Unified-Daughterboard/UDB-S/README.md

# Unified Daughterboard S Series

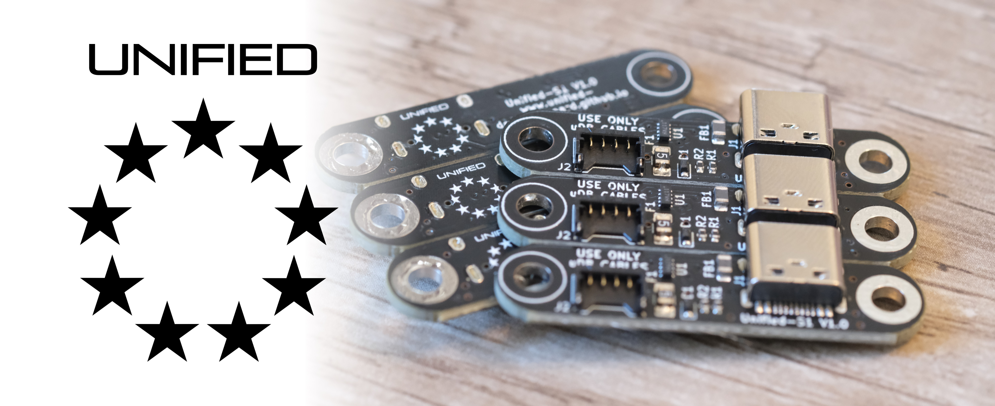
[picture p1: assets/S1-Banner-Img.jpg]
banner


## Introduction
The Unified Daughterboard Project is an open standard to unify the USB daughterboards used in custom mechanical keyboard projects.  
The Unified Daughterboard allows designers to easily implementing electrical protection via a tested proven PCB, and allows users to maintain and repair their keyboards in the future.  
  
For more details on the Unified Daughterboard project, see the [main website](https://unified-daughterboard.github.io/).

## S Series

The S1 variant was developed as an entirely new form factor from the older C3 version based on real-world production usage and designer input.

- "Wide and narrow" 40mm wide x 9mm deep x 1.6mm thick form factor
    - Avoids obstacles such as weights commonly found in custom keyboards
    - Mountable both right-side-up and upside-down
- 2 x M3 mounting points 
    - Fewer large screw taps reduce thread defect issues and assembly effort
- Easy and inexpensive to source via JLCPCB or similar
- Large DB corner radii which allow keyboard cases to be milled at a large inner radius
- ESD protection, overcurrent protection, overvoltage protection, shielding noise decoupling, and single-path grounding to chassis functionality
- New Molex Pico-EZmate Connector, replacing the JST-SH on previous versions
- 1:1 connector pinout to retain compatibility with existing PCBs

## Using the S series uDB in your design
Please [visit the docs](https://unified-daughterboard.github.io/) for detailed implementation references and notices.  

## Previews
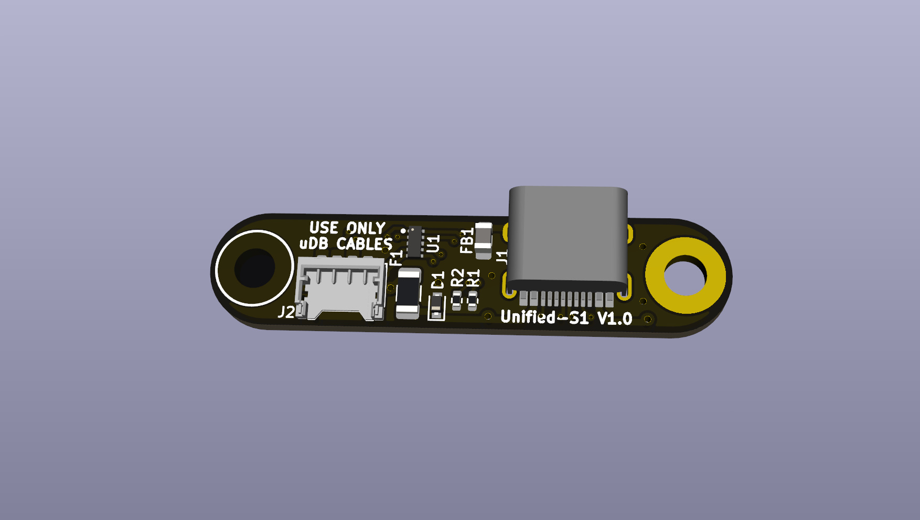
[picture p2: assets/front.jpg]

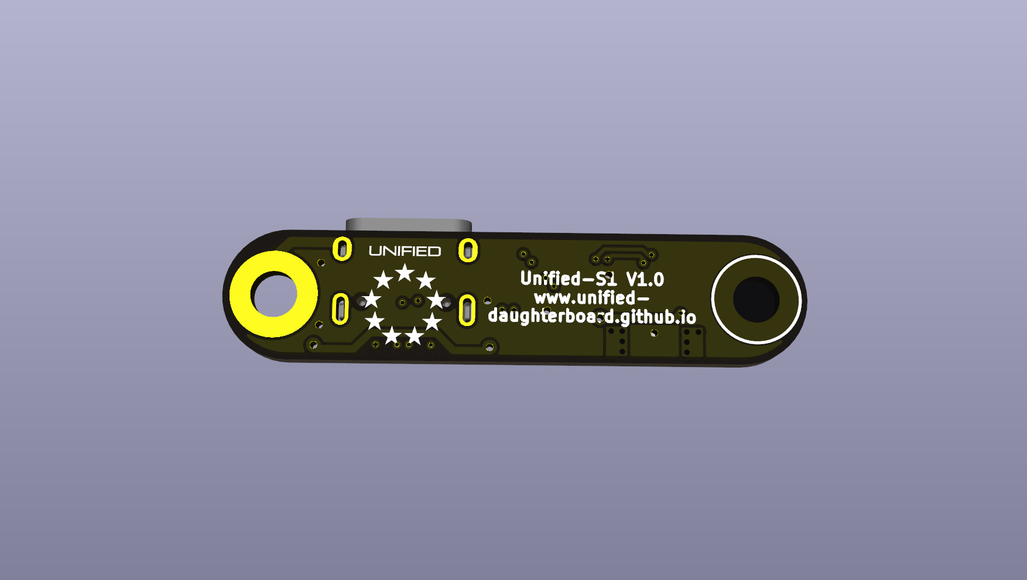
[picture p3: assets/rear.jpg]


## Credits
- [Gondolindrim](https://github.com/Gondolindrim)
- [hineybush](https://hineybush.com/)
- [ai03](https://ai03.com/)
- [GEON](https://geon.works/)
- [Sleepdealer](https://sleepdealer.xyz)
- [Xelus](https://xelus.me)
- [James (AKB)](https://alchemistkeyboards.com/)
- [kkatano](https://github.com/kkatano)
- [ToastyStoemp](https://vwolf.be)
- [Upas](https://cannonkeys.com)

C3 Unified:
- [Wilba](https://wilba.tech)
- Xondat
- [aeryxz](https://github.com/aeryxz)
- [Maximillian](https://github.com/Maximillian)
