Unified-Daughterboard/UDB-S/resources/Diagram-Cable-EZmate-Heatshrink.png

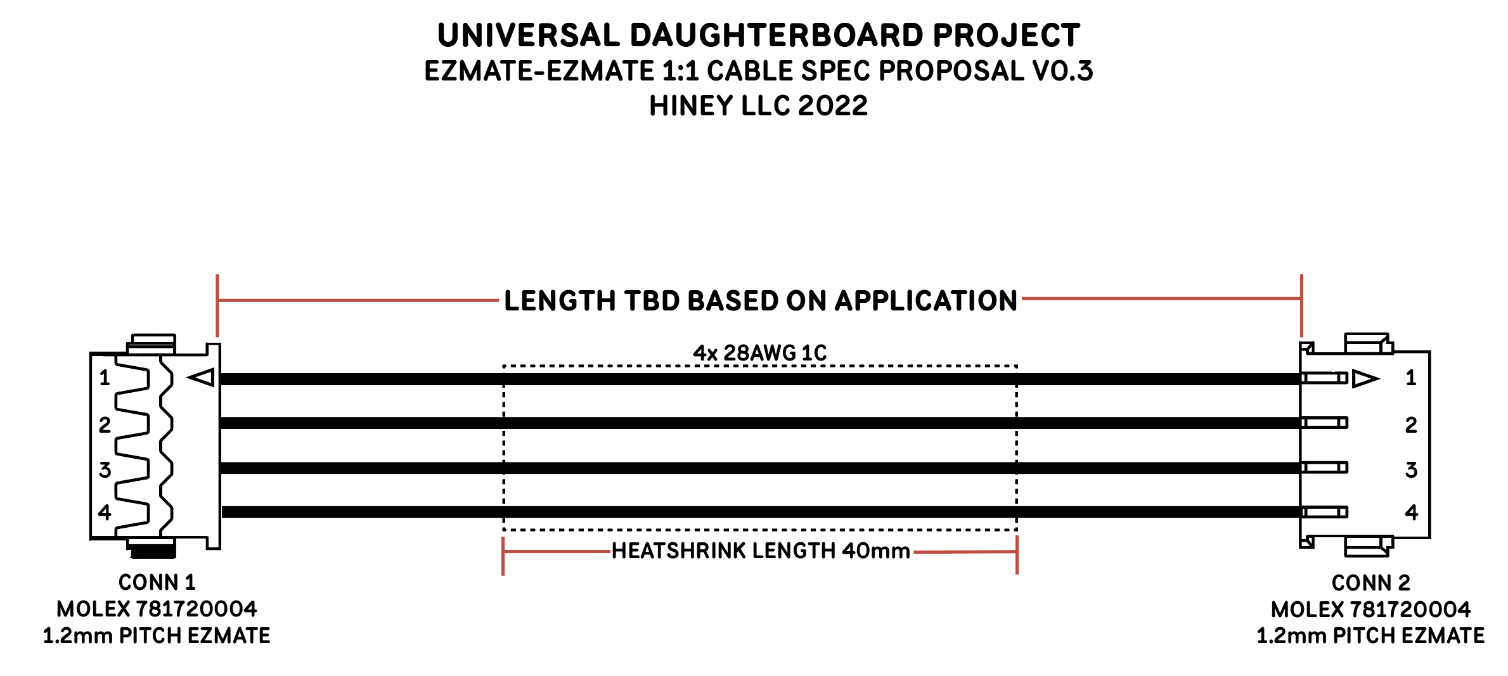
resources/Diagram-Cable-EZmate-Heatshrink.png
