Unified-Daughterboard/UDB-S/resources/Diagram-Cable-EZmate-NoHeatshrink.png

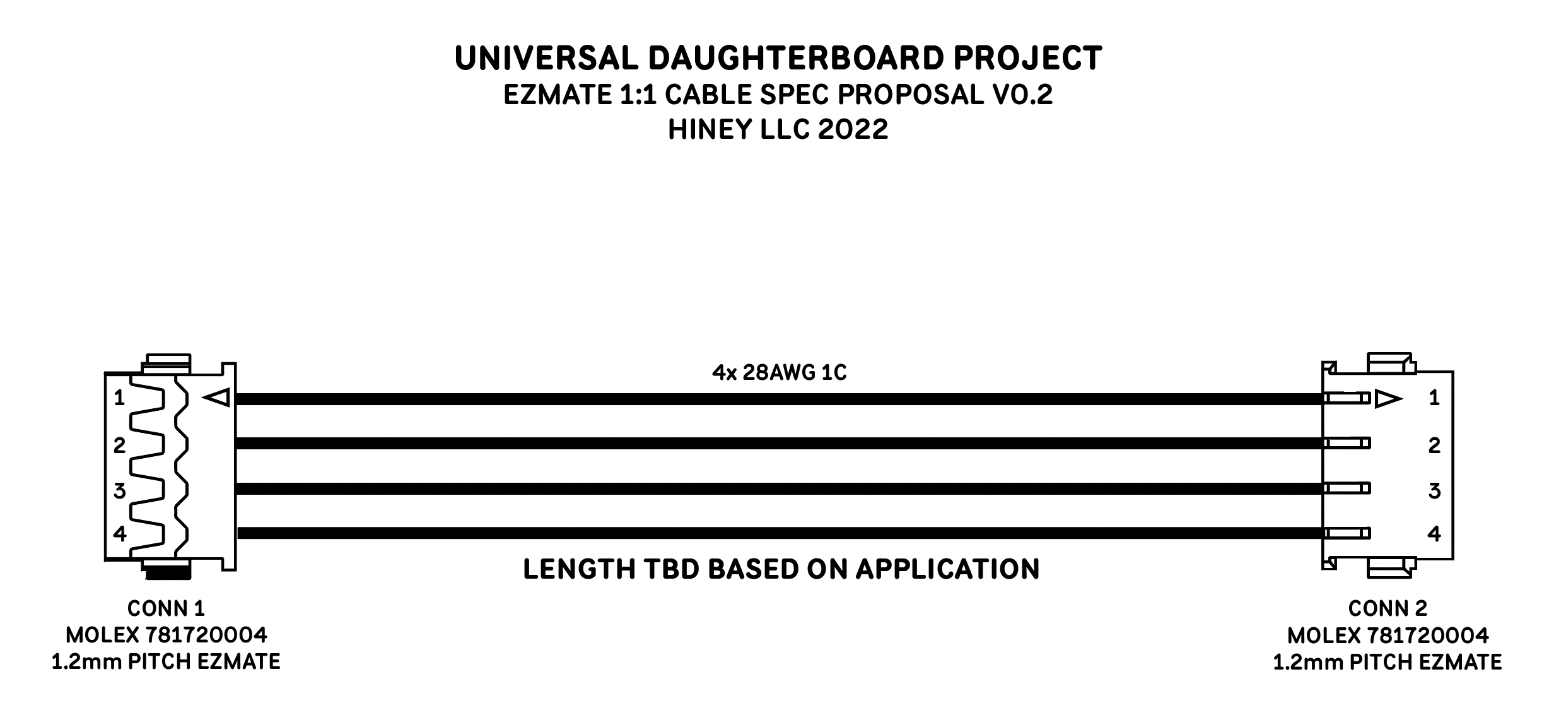
resources/Diagram-Cable-EZmate-NoHeatshrink.png
