Unified-Daughterboard/UDB-S/resources/Diagram-Cable-EZmateToJST-NoHeatshrink.png

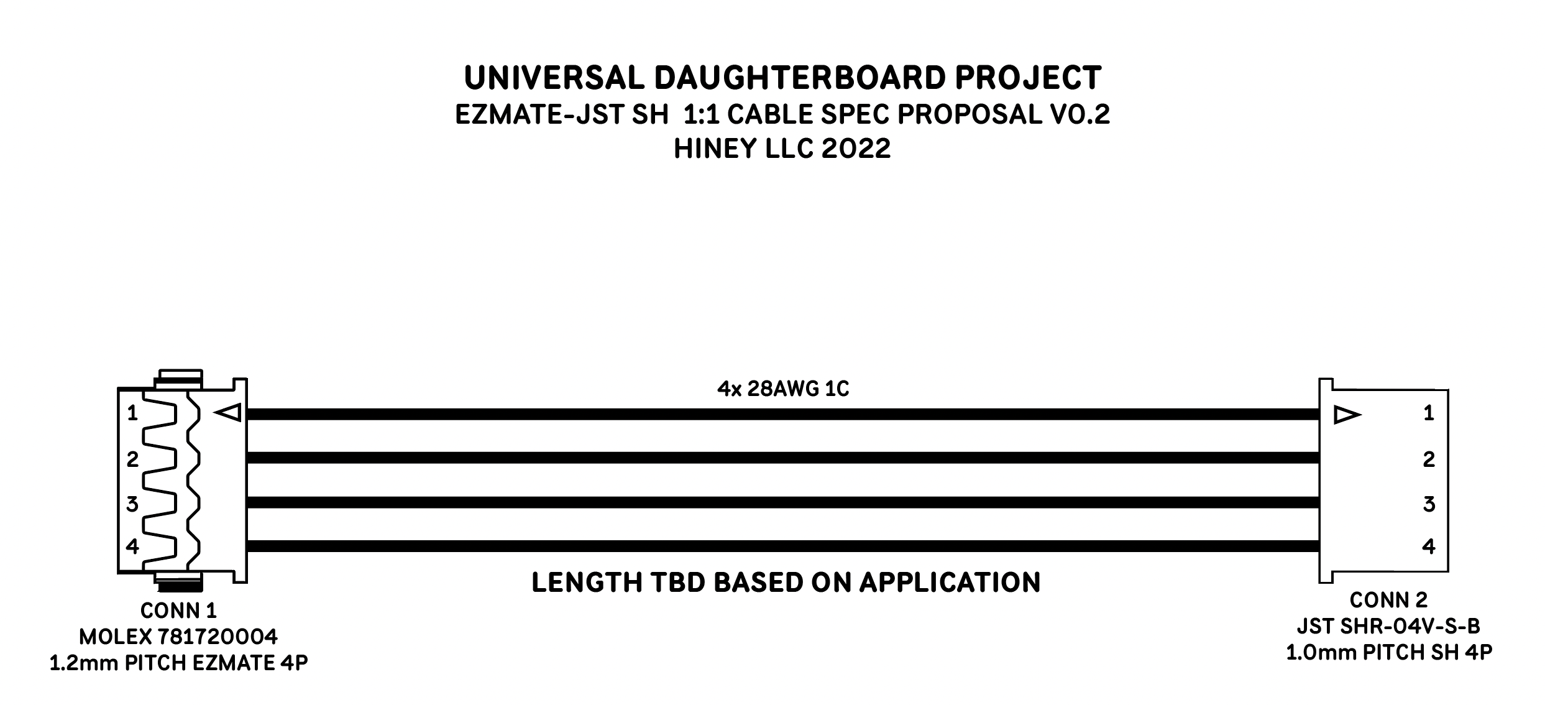
resources/Diagram-Cable-EZmateToJST-NoHeatshrink.png
