Unified-Daughterboard/UDB-S/resources/uDB-S1-dimens-side.jpg

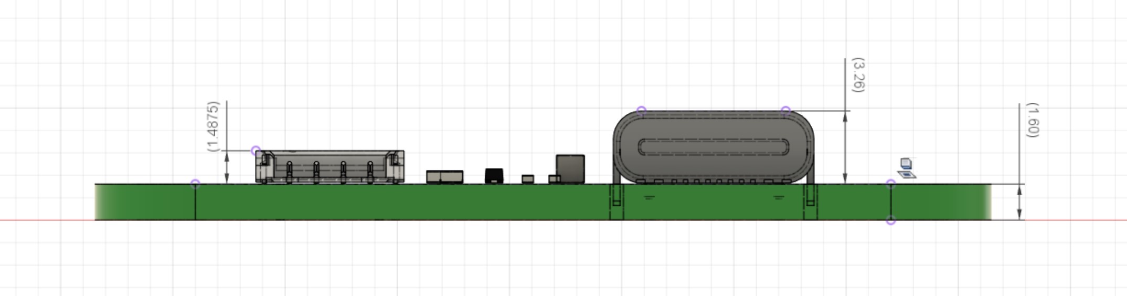
resources/uDB-S1-dimens-side.jpg
