Unified-Daughterboard/UDB-S/resources/uDB-S1-dimens-top.jpg

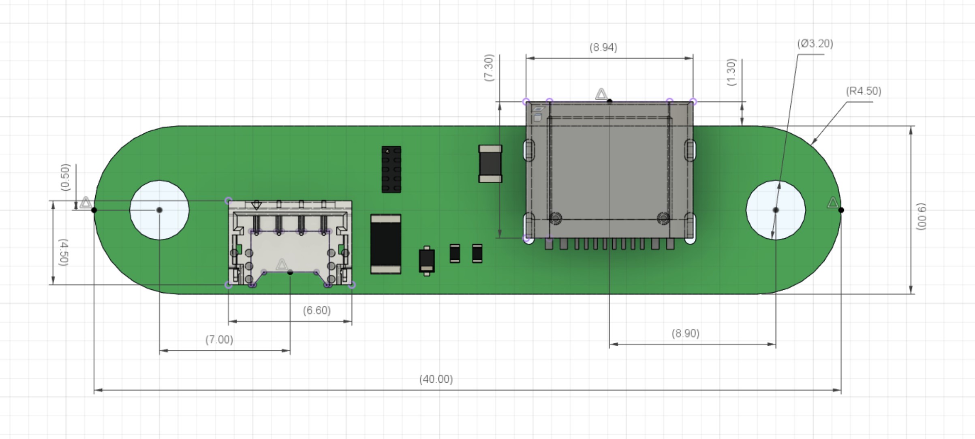
resources/uDB-S1-dimens-top.jpg
