Unified-Daughterboard/UDB-S/production/usb-s1-bom.xls

Comment | Designator | Footprint | JLCPCB Part #
TPD4E05U06DQAR | U1 | acheron_Components:USON-10_2.5x1.0mm_P0.5mm | C2836386
TYPE-C-31-M-12 | J1 | acheron_Connectors:USB_C_Receptacle_Hroparts_TYPE-C-31-M-12 | C165948
ESD5Z5V0 | D1 | Diode_SMD:D_SOD-523 | C727161
SMD0805-050-16V | F1 | Fuse:Fuse_1206_3216Metric | C968441
GZ2012D601TF | FB1 | Inductor_SMD:L_0805_2012Metric | C1017
5.1k | R1,R2 | Resistor_SMD:R_0402_1005Metric | C25905
78171-0004 | J2 | acheron_Connectors:MOLEX_781710004_MountingReliefs | C528030
