Unified-Daughterboard/UDB-S/resources/uDB-S1-implementation-example.step

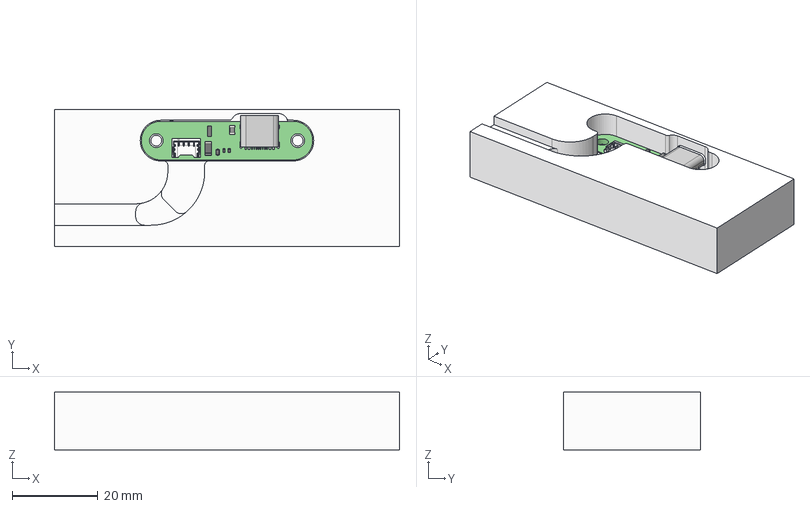
[picture p9: CAD file, 2023-01-15]
resources/uDB-S1-implementation-example.step
80.5 x 32.0 x 13.5 mm
udb-s PCB
Example Shell
