Unified-Daughterboard/UDB-S/udb-s.step

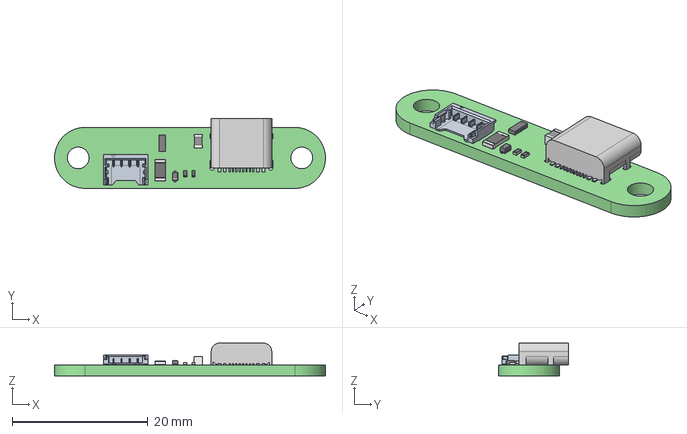
[picture p10: CAD file, 2023-01-12]
udb-s.step
40.0 x 10.3 x 4.87 mm
udb-s PCB
