Unified-Daughterboard/UDB-S/resources/uDB-S1-implementation-example-reverse.step

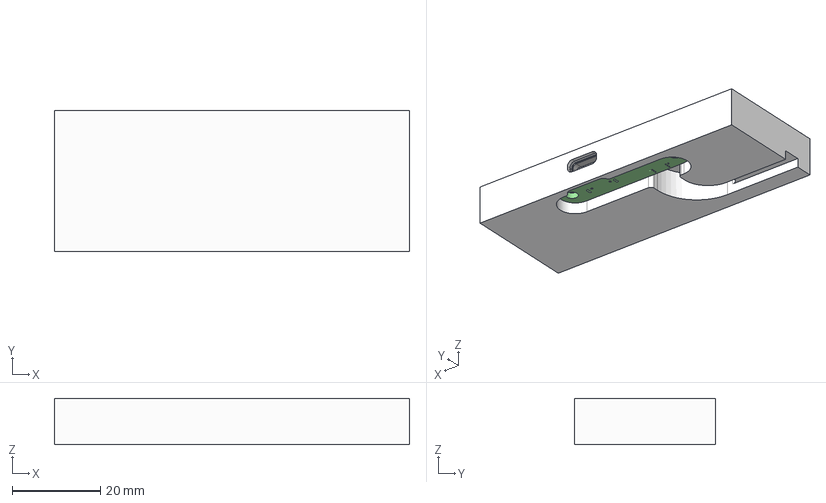
[picture p11: CAD file, 2023-01-15]
resources/uDB-S1-implementation-example-reverse.step
80.5 x 32.0 x 10.5 mm
udb-s PCB
Example Shell
