Unified-Daughterboard/UDB-S/(list of files, cad)

Other CAD files:
resources/uDB-S1-3D-model.STEP
