Unified-Daughterboard/UDB-S/(threads)

Thread 2 (2023-03-22):

Production BOM Typo

p3dstore, 2023-03-22:
The BOM calls out 0805 package for F1 but gerbers are designed for 1206 package part.

doctorboyMP, 2023-05-02:
Reference in the BOM file regarding the LCSC part number also points to a component using the 0805 package.
Maybe part C883124 from BHFuse is a good alternative (also available in JLCPCB parts).

Na-Cly, 2023-07-04:
Agree. Elecrow pointed out the footprint is for 1206 and the fuse in the bom is an 805

Thread 4 (2023-04-26):

Specify pinout in documentation

pbhogan, 2023-04-26:
I know it's a silly little thing, but I spent quite a while looking for the connector pinout in the documentation. It would be nice to have it outlined on the PCB designer page somewhere. Had to download and open up the project in KiCad to find it:

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

Thread 5 (2023-05-29):

Dimensions too small for JLCPCB assembly

danieltaylor, 2023-05-29:
The README states that the board is "easy and inexpensive to source via JLCPCB or similar," but I found that it is 1mm too narrow to qualify for their PCB assembly service.  (The requirement is a minimum of 10mm x 10mm, and the UDB-S is 40mm x 9 mm.)

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<brr>

Would it be possible to adjust the board dimensions slightly to meet these requirements?  I know that would mean modifying the standard, but it would make the board a lot more accessible and likely cheaper compared to having to source the parts separately and solder them on after.

If not, I would love some other suggestions on how I can get some of these boards made.  Clearly it has been done, so maybe I'm doing something wrong on JLCPCB, need to order somewhere else, or just need to find the other components and (attempt to) solder them myself.  I'd love some help determining the best course of action.  Thanks!

Gondolindrim, 2023-05-30:
Weirdly enough the PCBs were prototyped using JLC and as far as we are aware there were no issues. We will discuss this

Thread 6 (2023-06-27):

Reverse implementation example contains unmachinable feature

corykinney, 2023-06-27:
The [uDB-S1-implementation-example-reverse.step](https://github.com/Unified-Daughterboard/UDB-S/blob/main/resources/uDB-S1-implementation-example-reverse.step) file contains a fillet that can not be machined due to raised material for the mounting face that would block the toolpath. I'm assuming that material shouldn't be there as it looks very strange.

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

Environment: Fusion 360 2.0.16488 x86_64
