Unified-Daughterboard/UDB-S/(commit log)

2022-09-17 Add components metadata; first proposed version
    [udb-s.kicad_pcb, udb-s.kicad_sch]
2022-09-17 Implement hybrid screw holes + USB lip
    [udb-s.kicad_pcb]
2022-09-17 Add 10-star logo
    [udb-s.kicad_pcb]
2022-09-17 Fix UNIFIED-S1 logo position
    [udb-s.kicad_pcb]
2022-09-17 Add silkscreen for under-the-usb VIAs to prevent shorting
    [udb-s.kicad_pcb]
2022-09-21 Remove hybrid screw footprint, reduce size to 40x9mm
    [udb-s.kicad_pcb, udb-s.kicad_sch]
2022-10-09 Port ober to Molex' EZMate
    [udb-s.kicad_pcb, udb-s.kicad_sch]
2022-11-27 Invert Molex pinout
    [udb-s.kicad_sch]
2022-11-27 Reroute with new conn
    [udb-s.kicad_pcb, udb-s.kicad_sch]
2022-11-27 Add 3D models
    [udb-s.kicad_pcb]
2022-11-27 Adjust conn footprint issues and positions
    [udb-s.kicad_pcb, udb-s.kicad_sch, udb-s.step]
2022-11-27 Update 3D model
    [udb-s.step]
2022-11-27 Finalize for review
    [udb-s.kicad_pcb]
2022-11-27 Adjust USB leg size
    [udb-s.kicad_pcb]
2022-11-27 Fix USB trace width and match lengths
    [udb-s.kicad_pcb]
2022-12-09 Invert pinout back to 1-1
    [udb-s.kicad_pcb, udb-s.kicad_sch]
2023-01-12 Add cable diagrams
2023-01-15 Add 3D model and annotated diagrams
    [uDB-S1-3D-model.STEP]
2023-01-15 Add example implementation models
    [uDB-S1-implementation-example-reverse.step, uDB-S1-implementation-example.step]
2023-01-17 Add production files from Upas
    [usb-s1-bom.xls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]
2023-02-21 Organize footprint names in F.Fab
    [udb-s.kicad_pcb]
2023-02-21 Add correct GND net designation to EZP connector mounting pads
    [udb-s.kicad_pcb]
2023-02-21 Remove unnecessary GND traces
    [udb-s.kicad_pcb]
2023-02-21 Reroute USB traces: skews tuned
    [udb-s.kicad_pcb]
2023-02-21 Fillet tracks; re-tune skew phase adjustments on USB traces, minor ground pour improvements
    [udb-s.kicad_pcb, udb-s.kicad_sch]
2023-03-29 Update front Silkscreen to say S1.1
    [udb-s.kicad_pcb]
2023-05-09 Update production resources to S1.1
    [udb-s-top-pos.csv]
